m-labs/milkymist/cores/tmu2/test_all/lena.jpg

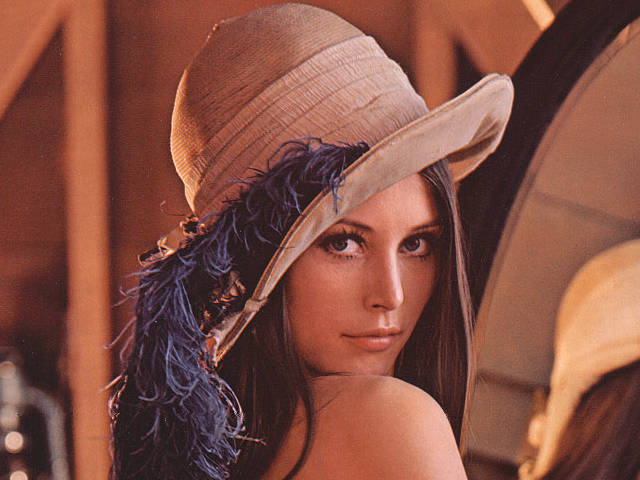
cores/tmu2/test_all/lena.jpg
