m-labs/milkymist/cores/fmlbrg/rtl/fmlbrg_datamem.v

/*
 * Milkymist SoC
 * Copyright (C) 2007, 2008, 2009, 2010 Sebastien Bourdeauducq
 *
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
 * You should have received a copy of the GNU General Public License
 * along with this program.  If not, see <http://www.gnu.org/licenses/>.
 */

module fmlbrg_datamem #(
	parameter depth = 11
) (
	input sys_clk,

	/* Primary port (read-write) */
	input [depth-1:0] a,
	input [7:0] we,
	input [63:0] di,
	output [63:0] do,

	/* Secondary port (read-only) */
	input [depth-1:0] a2,
	output [63:0] do2
);

reg [7:0] ram0[0:(1 << depth)-1];
reg [7:0] ram1[0:(1 << depth)-1];
reg [7:0] ram2[0:(1 << depth)-1];
reg [7:0] ram3[0:(1 << depth)-1];
reg [7:0] ram4[0:(1 << depth)-1];
reg [7:0] ram5[0:(1 << depth)-1];
reg [7:0] ram6[0:(1 << depth)-1];
reg [7:0] ram7[0:(1 << depth)-1];

wire [7:0] ram0di;
wire [7:0] ram1di;
wire [7:0] ram2di;
wire [7:0] ram3di;
wire [7:0] ram4di;
wire [7:0] ram5di;
wire [7:0] ram6di;
wire [7:0] ram7di;

wire [7:0] ram0do;
wire [7:0] ram1do;
wire [7:0] ram2do;
wire [7:0] ram3do;
wire [7:0] ram4do;
wire [7:0] ram5do;
wire [7:0] ram6do;
wire [7:0] ram7do;

wire [7:0] ram0do2;
wire [7:0] ram1do2;
wire [7:0] ram2do2;
wire [7:0] ram3do2;
wire [7:0] ram4do2;
wire [7:0] ram5do2;
wire [7:0] ram6do2;
wire [7:0] ram7do2;

reg [depth-1:0] a_r;
reg [depth-1:0] a2_r;

always @(posedge sys_clk) begin
	a_r <= a;
	a2_r <= a2;
end

always @(posedge sys_clk) begin
	if(we[0])
		ram0[a] <= ram0di;
end
assign ram0do = ram0[a_r];
assign ram0do2 = ram0[a2_r];

always @(posedge sys_clk) begin
	if(we[1])
		ram1[a] <= ram1di;
end
assign ram1do = ram1[a_r];
assign ram1do2 = ram1[a2_r];

always @(posedge sys_clk) begin
	if(we[2])
		ram2[a] <= ram2di;
end
assign ram2do = ram2[a_r];
assign ram2do2 = ram2[a2_r];

always @(posedge sys_clk) begin
	if(we[3])
		ram3[a] <= ram3di;
end
assign ram3do = ram3[a_r];
assign ram3do2 = ram3[a2_r];

always @(posedge sys_clk) begin
	if(we[4])
		ram4[a] <= ram4di;
end
assign ram4do = ram4[a_r];
assign ram4do2 = ram4[a2_r];

always @(posedge sys_clk) begin
	if(we[5])
		ram5[a] <= ram5di;
end
assign ram5do = ram5[a_r];
assign ram5do2 = ram5[a2_r];

always @(posedge sys_clk) begin
	if(we[6])
		ram6[a] <= ram6di;
end
assign ram6do = ram6[a_r];
assign ram6do2 = ram6[a2_r];

always @(posedge sys_clk) begin
	if(we[7])
		ram7[a] <= ram7di;
end
assign ram7do = ram7[a_r];
assign ram7do2 = ram7[a2_r];

assign ram0di = di[7:0];
assign ram1di = di[15:8];
assign ram2di = di[23:16];
assign ram3di = di[31:24];
assign ram4di = di[39:32];
assign ram5di = di[47:40];
assign ram6di = di[55:48];
assign ram7di = di[63:56];

assign do = {ram7do, ram6do, ram5do, ram4do, ram3do, ram2do, ram1do, ram0do};
assign do2 = {ram7do2, ram6do2, ram5do2, ram4do2, ram3do2, ram2do2, ram1do2, ram0do2};

endmodule
