m-labs/milkymist/cores/hpdmc_ddr32/rtl/spartan6/hpdmc_ddrio.v

/*
 * Milkymist SoC
 * Copyright (C) 2007, 2008, 2009, 2010 Sebastien Bourdeauducq
 *
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
 * You should have received a copy of the GNU General Public License
 * along with this program.  If not, see <http://www.gnu.org/licenses/>.
 */

module hpdmc_ddrio(
	input sys_clk,
	input sys_clk_n,

	input direction,
	input [7:0] mo,
	input [63:0] do,
	output [63:0] di,
	
	output [3:0] sdram_dm,
	inout [31:0] sdram_dq,
	inout [3:0] sdram_dqs,
	
	input idelay_rst,
	input idelay_ce,
	input idelay_inc,
	input idelay_cal
);

/******/
/* DQ */
/******/

wire [31:0] sdram_dq_t;
wire [31:0] sdram_dq_out;
wire [31:0] sdram_dq_in;
wire [31:0] sdram_dq_in_delayed;

hpdmc_iobuf32 iobuf_dq(
	.T(sdram_dq_t),
	.I(sdram_dq_out),
	.O(sdram_dq_in),
	.IO(sdram_dq)
);

hpdmc_oddr32 oddr_dq_t(
	.Q(sdram_dq_t),
	.C0(sys_clk),
	.C1(sys_clk_n),
	.CE(1'b1),
	.D0({32{direction}}),
	.D1({32{direction}}),
	.R(1'b0),
	.S(1'b0)
);

hpdmc_oddr32 oddr_dq(
	.Q(sdram_dq_out),
	.C0(sys_clk),
	.C1(sys_clk_n),
	.CE(1'b1),
	.D0(do[63:32]),
	.D1(do[31:0]),
	.R(1'b0),
	.S(1'b0)
);

hpdmc_idelay32 dq_delay(
	.IDATAIN(sdram_dq_in),
	.DATAOUT(sdram_dq_in_delayed),
	.INC(idelay_inc),
	.CE(idelay_ce),
	.RST(idelay_rst),
	.CAL(idelay_cal),
	.CLK(sys_clk),
	.IOCLK0(sys_clk),
	.IOCLK1(sys_clk_n)
);

hpdmc_iddr32 iddr_dq(
	.Q0(di[31:0]),
	.Q1(di[63:32]),
	.C0(sys_clk),
	.C1(sys_clk_n),
	.CE(1'b1),
	.D(sdram_dq_in_delayed),
	.R(1'b0),
	.S(1'b0)
);

/*******/
/* DM */
/*******/

hpdmc_oddr4 oddr_dm(
	.Q(sdram_dm),
	.C0(sys_clk),
	.C1(sys_clk_n),
	.CE(1'b1),
	.D0(mo[7:4]),
	.D1(mo[3:0]),
	.R(1'b0),
	.S(1'b0)
);

/*******/
/* DQS */
/*******/

wire [3:0] sdram_dqs_t;
wire [3:0] sdram_dqs_out;
wire [3:0] sdram_dqs_in_undelayed;
wire [3:0] sdram_dqs_in; /* TODO: use this for clocking input regs */

hpdmc_iobuf4 iobuf_dqs(
	.T(sdram_dqs_t),
	.I(sdram_dqs_out),
	.O(sdram_dqs_in_undelayed),
	.IO(sdram_dqs)
);

wire [3:0] sdram_dqs_t_undelayed;
wire [3:0] sdram_dqs_out_undelayed;

hpdmc_iodelay4 dqs_delay(
	.IDATAIN(sdram_dqs_in_undelayed),
	.DATAOUT(sdram_dqs_in),

	.T(sdram_dqs_t_undelayed),
	.TOUT(sdram_dqs_t),
	.ODATAIN(sdram_dqs_out_undelayed),
	.DOUT(sdram_dqs_out),
	
	.INC(1'b0),
	.CE(1'b0),
	.RST(idelay_rst),
	.CAL(idelay_cal),
	.CLK(sys_clk),
	.IOCLK0(sys_clk),
	.IOCLK1(sys_clk_n)
);

hpdmc_oddr4 oddr_dqs_t(
	.Q(sdram_dqs_t_undelayed),
	.C0(sys_clk),
	.C1(sys_clk_n),
	.CE(1'b1),
	.D0({4{direction}}),
	.D1({4{direction}}),
	.R(1'b0),
	.S(1'b0)
);

hpdmc_oddr4 oddr_dqs(
	.Q(sdram_dqs_out_undelayed),
	.C0(sys_clk),
	.C1(sys_clk_n),
	.CE(1'b1),
	.D0(4'hf),
	.D1(4'h0),
	.R(1'b0),
	.S(1'b0)
);

endmodule
