m-labs/milkymist/softusb-input/crc.c

/*
 * Milkymist SoC (USB firmware)
 * Copyright (C) 2007, 2008, 2009, 2010 Sebastien Bourdeauducq
 *
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
 * You should have received a copy of the GNU General Public License
 * along with this program.  If not, see <http://www.gnu.org/licenses/>.
 */

#include "progmem.h"
#include "crc.h"

unsigned char usb_crc5(unsigned char b1, unsigned char b2)
{
	unsigned char crc;
	unsigned char nextb;
	unsigned char so;
	unsigned char i;

	crc = 0x1f;

	for(i=0;i<8;i++) {
		nextb = b1 & 0x01;
		b1 >>= 1;
		so = crc & 0x01;
		crc >>= 1;
		if(nextb != so)
			crc ^= 0x14;
	}
	for(i=0;i<3;i++) {
		nextb = b2 & 0x01;
		b2 >>= 1;
		so = crc & 0x01;
		crc >>= 1;
		if(nextb != so)
			crc ^= 0x14;
	}

	crc &= 0x1f;
	crc ^= 0x1f;

	return crc;
}

/* CRC16 based on usbdrvasm18.inc from V-USB */
static const char crc_table_lo[] PROGMEM = {
	0x00, 0xC1, 0x81, 0x40, 0x01, 0xC0, 0x80, 0x41,
	0x01, 0xC0, 0x80, 0x41, 0x00, 0xC1, 0x81, 0x40,
	0x01, 0xC0, 0x80, 0x41, 0x00, 0xC1, 0x81, 0x40,
	0x00, 0xC1, 0x81, 0x40, 0x01, 0xC0, 0x80, 0x41,
	0x01, 0xC0, 0x80, 0x41, 0x00, 0xC1, 0x81, 0x40,
	0x00, 0xC1, 0x81, 0x40, 0x01, 0xC0, 0x80, 0x41,
	0x00, 0xC1, 0x81, 0x40, 0x01, 0xC0, 0x80, 0x41,
	0x01, 0xC0, 0x80, 0x41, 0x00, 0xC1, 0x81, 0x40,
	0x01, 0xC0, 0x80, 0x41, 0x00, 0xC1, 0x81, 0x40,
	0x00, 0xC1, 0x81, 0x40, 0x01, 0xC0, 0x80, 0x41,
	0x00, 0xC1, 0x81, 0x40, 0x01, 0xC0, 0x80, 0x41,
	0x01, 0xC0, 0x80, 0x41, 0x00, 0xC1, 0x81, 0x40,
	0x00, 0xC1, 0x81, 0x40, 0x01, 0xC0, 0x80, 0x41,
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
{
	unsigned char lo, hi;
	unsigned char i;
	unsigned char idx;
	
	lo = 0xff;
	hi = 0xff;
	for(i=0;i<len;i++) {
		idx = lo ^ msg[i];
		lo = read_pgm_byte(crc_table_lo + idx) ^ hi;
		hi = read_pgm_byte(crc_table_hi + idx);
	}
	dest[0] = ~lo;
	dest[1] = ~hi;
}
