m-labs/milkymist/cores/softusb/navre_regress/tb_regress.v

/*
 * Milkymist SoC
 * Copyright (C) 2007, 2008, 2009, 2010 Sebastien Bourdeauducq
 *
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
 * You should have received a copy of the GNU General Public License
 * along with this program.  If not, see <http://www.gnu.org/licenses/>.
 */

module tb_regress();

reg sys_clk;
initial sys_clk = 1'b1;
always #5 sys_clk = ~sys_clk;

reg sys_rst;

wire pmem_ce;
wire [11:0] pmem_a;
reg [15:0] pmem_d;

reg [15:0] pmem[0:4095];

always @(posedge sys_clk) begin
	if(pmem_ce)
		pmem_d <= pmem[pmem_a];
end


wire dmem_we;
wire [9:0] dmem_a;
reg [7:0] dmem_di;
wire [7:0] dmem_do;

reg [7:0] dmem[0:1023];

always @(posedge sys_clk) begin
	if(dmem_we) begin
		//$display("DMEM WRITE: adr=%d dat=%d", dmem_a, dmem_do);
		dmem[dmem_a] <= dmem_do;
	end
	dmem_di <= dmem[dmem_a];
end

wire io_re;
wire io_we;
wire [5:0] io_a;
wire [7:0] io_do;
reg [7:0] io_di;

always @(posedge sys_clk) begin
	if(~sys_rst) begin
		if(io_re) begin
			$display("IO READ adr=%x", io_a);
			io_di <= io_a;
		end
		if(io_we) begin
			$display("IO WRITE adr=%x dat=%x", io_a, io_do);
		end
	end
end

task dump;
integer i;
begin
	$display("DUMP DMEM");
	for(i=0;i<1023;i=i+1)
		$display("%x", dmem[i]);
end
endtask

softusb_navre #(
	.pmem_width(12),
	.dmem_width(10)
) dut (
	.clk(sys_clk),
	.rst(sys_rst),

	.pmem_ce(pmem_ce),
	.pmem_a(pmem_a),
	.pmem_d(pmem_d),

	.dmem_we(dmem_we),
	.dmem_a(dmem_a),
	.dmem_di(dmem_di),
	.dmem_do(dmem_do),

	.io_re(io_re),
	.io_we(io_we),
	.io_a(io_a),
	.io_do(io_do),
	.io_di(io_di),

	.irq(8'b0),

	.dbg_pc()
);

initial begin
	$readmemh("flash.rom", pmem);
	$readmemh("sram.rom", dmem);
	sys_rst = 1'b1;
	#15;
	sys_rst = 1'b0;
end

endmodule
