m-labs/milkymist/cores/tmu2/rtl/tmu2_tdpram.v

/*
 * Milkymist SoC
 * Copyright (C) 2007, 2008, 2009, 2010, 2011 Sebastien Bourdeauducq
 *
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
 * You should have received a copy of the GNU General Public License
 * along with this program.  If not, see <http://www.gnu.org/licenses/>.
 */

/* Dual-port RAM with dual write-capable port */

module tmu2_tdpram #(
	parameter depth = 11, /* < log2 of the capacity in words */
	parameter width = 32
) (
	input sys_clk,

	input [depth-1:0] a,
	input we,
	input [width-1:0] di,
	output reg [width-1:0] do,

	input [depth-1:0] a2,
	input we2,
	input [width-1:0] di2,
	output reg [width-1:0] do2
);

reg [width-1:0] ram[0:(1 << depth)-1];


always @(posedge sys_clk) begin
	if(we)
		ram[a] <= di;
	do <= ram[a];
end

always @(posedge sys_clk) begin
	if(we2)
		ram[a2] <= di2;
	do2 <= ram[a2];
end

// synthesis translate_off

/*
 * For some reason, in Verilog the result of an undefined multiplied by zero
 * seems to be undefined.
 * This causes problems with pixels that texcache won't fetch because some fractional
 * parts are zero: the blend unit yields an undefined result on those, instead of ignoring
 * the contribution of the undefined pixel.
 * Work around this by initializing the memories.
 */

integer i;
initial begin
	for(i=0;i<(1 << depth);i=i+1)
		ram[i] = 0;
end

// synthesis translate_on

endmodule
