m-labs/milkymist/cores/vgafb/rtl/vgafb_fifo64to16.v

/*
 * Milkymist SoC
 * Copyright (C) 2007, 2008, 2009 Sebastien Bourdeauducq
 *
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
 * You should have received a copy of the GNU General Public License
 * along with this program.  If not, see <http://www.gnu.org/licenses/>.
 */

module vgafb_fifo64to16(
	input sys_clk,
	input vga_rst,
	
	input stb,
	input [63:0] di,
	
	output can_burst,
	output do_valid,
	output reg [15:0] do,
	input next /* should only be asserted when do_valid = 1 */
);

/*
 * FIFO can hold 8 64-bit words
 * that is 32 16-bit words.
 */

reg [63:0] storage[0:7];
reg [2:0] produce; /* in 64-bit words */
reg [4:0] consume; /* in 16-bit words */
/*
 * 16-bit words stored in the FIFO, 0-32 (33 possible values)
 */
reg [5:0] level;

wire [63:0] do64;
assign do64 = storage[consume[4:2]];

always @(*) begin
	case(consume[1:0])
		2'd0: do <= do64[63:48];
		2'd1: do <= do64[47:32];
		2'd2: do <= do64[31:16];
		2'd3: do <= do64[15:0];
	endcase
end

always @(posedge sys_clk) begin
	if(vga_rst) begin
		produce = 3'd0;
		consume = 5'd0;
		level = 6'd0;
	end else begin
		if(stb) begin
			storage[produce] = di;
			produce = produce + 3'd1;
			level = level + 6'd4;
		end
		if(next) begin /* next should only be asserted when do_valid = 1 */
			consume = consume + 5'd1;
			level = level - 6'd1;
		end
	end
end

assign do_valid = ~(level == 6'd0);
assign can_burst = level <= 6'd16;

endmodule
