m-labs/milkymist/(commit log)

2009-08-17 Import into GitHub
    [texel_cache.ods]
2009-08-19 Move LM32 config to board dir
2009-08-21 Sync UART operation for crash debugging
2009-08-23 Working on Avnet board
2009-09-06 Milkymist One board WIP
2009-09-08 Fixed DDR I/O problems
    [hpdmc.v, hpdmc_datactl.v, hpdmc_ddrio.v, setup.v]
2009-09-12 Fixed buffer overflow in cffat
    [cffat.c]
2009-09-20 WIP fix synthesis for S6 with ISE 11.3
    [hpdmc_oddr4.v]
2009-09-23 kernel reboot (support warm boot entry @ 0x00000100)
    [main.c]
2009-10-02 Moved files
    [texel_cache.ods]
2009-10-02 Missing files
    [texel_cache.ods]
2009-11-05 merged (original)
    [flasher-routed_pad.csv, texel_cache.ods]
2009-11-08 Configurable byte swap in norflash8
    [norflash8.v, system.v, vga.h]
2009-11-12 Active high interrupts in LM32
2009-11-13 Edge sensitive IRQ on UART
2009-11-13 UART fix
2009-11-13 Timer fix
2009-12-12 Workaround for strange Xst bug
    [fmlbrg_datamem.v, hpdmc_ddrio.v, setup.v]
2009-12-29 PS/2 interrupt doc
2010-01-10 Reverted to old VGA, new one does not work
    [setup.v, vga.v, vgafb.v]
2010-01-14 Dropped support for Avnet Spartan3A board - now available as Fallen's fork
2010-01-30 SDRAM timing fixes from Zeus
    [hpdmc_datactl.v, setup.v]
2010-02-02 vdivops stage + tb
2010-02-02 connected, syntax ok, not working
    [tmu2.v, tmu2_divider17.v, tmu2_geninterp18.v, tmu2_vdivops.v, tmu2_vinterp.v]
2010-02-08 Vertical interpolation bugfix WIP
    [tb_tmu2.v, tmu2.v, tmu2_geninterp18.v, tmu2_vdiv.v, tmu2_vdivops.v, tmu2_vinterp.v]
2010-02-09 Avoid Verilog trap (thanks Paul Campbell for pointing that out)
    [tmu2_geninterp18.v, tmu2_hinterp.v]
2010-02-09 mask + clamp
2010-02-13 Bilinear filtering OK in simulation
2010-02-14 Model using DSP48 primitives to work around Xst bugs
    [DSP48.v, tb_tmu2.v]
2010-02-14 workarounds for synthesizer problems
    [tb_tmu2.v, tmu2_blend.v, tmu2_mult2.v, tmu2_qpram.v]
2010-02-14 Fixed CE pin on multipliers + iverilog support
    [tb_tmu2.v, tmu2.v, tmu2_blend.v, tmu2_mult2.v, vpi_images.c]
2010-02-15 new write buffer doesnt work, simulators and synthesizers all give different results, fuck it and revert to the old one
    [DSP48.v, tb_tmu2.v, tmu2.v, vpi_images.c]
2010-02-15 Fixed clamp unit
2010-02-15 Improved PFPU timing + SW fixes
    [pfpu_dma.v, tb_pfpu.v]
2010-02-15 Simpler and smaller PFPU DMA engine
2010-02-16 Fixes + hack for picture brightness
    [pfpu.v]
2010-02-17 fix borders + initialize audio peaks + silently skip audio buffers
    [snd.c]
2010-02-18 TMU2 documentation
    [texel_cache.ods]
2010-02-26 interrupt numbers
2010-02-28 Use board description
2010-03-21 Fix typo in sysctl.tex (address of capabilities register) + move libbase include files
    [crc.h]
2010-03-28 Use FPVM in demo firmware (unfinished, broken)
    [libc.c]
2010-04-07 New FML arbiter, fixed DRAM write-to-read timing, alpha blending OK on hardware
    [fmlarb.v, hpdmc_datactl.v, system.v, tb_tmu2.v, tb_tmu2_arb.v, tmu2.v]
2010-04-14 Fixed race conditions in UI
    [main.c]
2010-04-25 Bilinear filtering explanation
2010-05-03 Section about wrapping/clamping
2010-05-07 Fix figure for BW prints
2010-05-16 libHPDMC with manual calibration
2010-06-21 BIOS starting on M1, SDRAM not working
    [norflash16.v]
2010-06-22 Ethernet working (experimental, random FIFO problems)
    [setup.v, system.v]
2010-06-22 PFPU working on M1. Added 1 pipeline stage to meet timing on multiplier.
2010-06-24 3 buttons pressed = hardware reset
    [system.v]
2010-06-28 Video input FIFO + DMA engine, untested
2010-06-28 Bugfixes in VPI image module
    [vpi_images.c]
2010-06-29 Integrated video in. Working but cleanup-needing I2C functions.
2010-06-30 I2C cleanup
2010-07-07 conbus: ignore the MSB
    This shadows 0000_0000-7fff_ffff to 8000_0000-ffff_ffff, which gives the
    possibility to access every device in cached and non-cached mode.
    The change also creates a new memory map:
    - NOR 0x00000000 (shadow @0x80000000)
    - USB 0x20000000 (shadow @0xa0000000)
    - FML bridge 0x40000000 (shadow @0xc0000000)
    - CSR bridge 0x60000000 (shadow @0xe0000000)
2010-07-08 Swap flash bytes for impact
    [norflash16.v]
2010-07-12 ZPU testbench + working on board
2010-07-13 Disable ZPU interrupts
2010-07-13 Fixed video in compilation warnings
    [vin.c]
2010-07-13 Fixed video in compilation warnings (again)
    [vin.c]
2010-07-14 Detect USB devices connection
2010-07-16 Fixed SIE address decoder
    [softusb_sie.v]
2010-07-19 Improved test bench + bugfixes
    [softusb_navre.v, tb_navre.v]
2010-07-19 Push/pop instructions + bugfixes. Recursive fibonacci works.
    [softusb_navre.v, tb_navre.v]
2010-07-20 Bugfixes - basic USB TX to SIE working
    [main.c, softusb.v, softusb_dpram.v, softusb_navre.v, softusb_ram.v, softusb_sie.v, tb_softusb.v]
2010-07-21 Load AVR firmware from HAL + fixes
    [softusb_ram.v, tb_softusb.v, usb.c]
2010-07-23 Multi RX slot in BIOS netboot + keep IRQ line asserted with RX reset
2010-07-23 Work around BRAM silicon bug^URespect conflict avoidance requirements
    [softusb_dpram.v]
2010-07-25 Memory card controller fixes + test bench
    [memcard.v, tb_memcard.v]
2010-07-28 Fixed timing problems + OHCI firmware cleanup
    [debug.c, main.c, pfpu.h, pfpu_faddsub.v]
2010-07-29 Display device connection and disconnection
2010-08-01 fix stupid metastability problem
    [main.c, sie.h, softusb_phy.v, softusb_rx.v]
2010-08-01 Do not tickle EDA tool bugs
    [softusb_tx.v]
2010-08-02 Map SREG at 0x3f + do not generate interrupt related instruction
2010-08-02 Cleanup IOs, USB device descriptor generally read correctly. Some bytes corrupted because of Navre bugs
    [debug.c, debug.h, io.h, main.c, progmem.h, sie.h, tb_navre.v, timer.h]
2010-08-02 Enable everything and fix timing problems
    [setup.v]
2010-08-03 Fix access to the upper 64M of SDRAM
    [fmlbrg.v, setup.v, tb_fmlbrg.v]
2010-08-12 Prevent DMX TX glitches
    [dmx_tx.v]
2010-08-12 DMX input working on the board
2010-08-19 Fixed Z handling with carry
    [softusb_navre.v]
2010-08-19 Fixed LDS instruction. All tests passing
    [softusb_navre.v]
2010-08-24 UART Thru mode
2010-08-30 Fix rescue bitstream load addresses
    [standby.v]
2010-08-31 Fix some SDRAM timing problems, new commands to control data input delay
    [ddram.v, hpdmc.v, hpdmc_ddrio.v, iodelay2.v]
2010-09-02 Demo firmware fix + video mode definitions
    [asfifo.v, system.v, vga.c, vga.h, vga.v]
2010-09-05 More sophisticated SDRAM clocking + disallow continuous read bursts (tickles some bug, why?)
    [boot.h, ddram.v, hpdmc.v, hpdmc_datactl.v, hpdmc_ddrio.v, main.c]
2010-09-06 Use the correct AC97 clock
    [system.v]
2010-09-10 Revert to data IDELAY for SDRAM DQ + use direct BUFG for AC97 clock
    [hpdmc_ddrio.v, system.v]
2010-09-10 Update calibration value in BIOS
2010-09-17 Fix program memory read in AVR firmware
    [progmem.h]
2010-09-18 Wishbone burst write support (nb: timing might be broken)
    [fmlbrg.v, tb_fmlbrg.v]
2010-09-21 Some monitor ROM fixes
    [monitor.v, system.v, tb_monitor.v]
2010-09-23 Print USB VID/PID (when lucky)
2010-09-25 Fix USB tx_busy generation
    [debug.c, io.h, softusb_filter.v, softusb_phy.v, softusb_sie.v]
2010-09-25 USB debug prints
2010-09-25 PCB revision readout
2010-09-30 USB bugfixes. Still many intermittent problems but now works with more than one device.
    [debug.c, main.c, softusb_rx.v]
2010-09-30 Report USB bit stuffing errors
    [main.c, sie.h, softusb_phy.v, softusb_rx.v, softusb_sie.v]
2010-09-30 Fix USB TX->RX switching generated glitches
    [softusb_phy.v]
2010-09-30 Retry on USB error
    [main.c]
2010-09-30 Use counter to reset RX + simpler xfer functions
    [main.c, softusb_filter.v, softusb_phy.v]
2010-09-30 Check interface descriptor and determine device type
2010-09-30 Print keyboard codes
2010-10-01 Keyboard codes transmission + interrupts (untested)
2010-10-01 Console hooks + use HAL and interrupts in BIOS
2010-10-01 Toggle console with ESC
2010-10-04 Atomic console prints
2010-10-05 More conservative interrupt handling
2010-10-05 Version command + fixes
    [main.c]
2010-10-05 Nested UART RX interrupt
2010-10-07 remove missing signal from tb
    [tb_sie.v]
2010-10-08 Fix USB disconnect bug on port A
    [main.c]
2010-10-08 Fix USB data packet handling
    [main.c]
2010-10-08 Do not send keepalive to unsupported devices (like full speed)
2010-10-08 USB cleanup + fix DATAx mismatch handling
    [main.c]
2010-10-15 Fix PFPU program load
    [pfpu.c]
2010-10-19 Fixes for HW debugging (Michael Walle)
    [norflash16.v, system.v, tb_norflash16.v]
2010-10-28 USB: fixed 'missing sync word' bug
    [softusb_tx.v]
2010-10-28 Last major USB bug gone
    [softusb_phy.v, softusb_rx.v]
2010-11-10 Work around GNUtard problems (http://gcc.gnu.org/bugzilla/show_bug.cgi?id=46261)
    [debug.c, debug.h, libc.c, libc.h, main.c, progmem.h]
2010-11-16 Fix boot problem with RTEMS 4.5 GCC toolchain
    [boot.c]
2010-11-18 Fix rescue mode detection
    [main.c]
2011-03-03 Use timer for boot timeout
2011-03-04 Claim to support PCB revision 2 (RC3 run)
2011-03-27 AC97: zero out invalid frames (needed for WM9707) and fix loading of downstream data register in full duplex operation
    [ac97_ctlif.v, ac97_dma.v]
2011-03-28 Support video mode switching
2011-03-31 uart: begin sampling with falling edge
2011-03-31 uart: fix thru bit initialization
2011-03-31 uart: add break support
    This patch adds UART BREAK support. A BREAK signal violates the framing by
    transmitting a logical 0 for a period that is at least longer than one
    frame.
2011-04-04 uart: add a tx pending status bit
2011-04-04 add UART BREAK support to the SoC
2011-04-04 gdbstub: initial import
    This patch adds a gdb stub which replaces the tiny LM32 debug monitor. It
    needs some more resources but has the advantage that you can directly
    connect with GDB.
    [gdbstub.c]
2011-04-05 flterm: add gdbpassthrough support
    This patch adds support for GDB packets and serial console demuxing. To use
    it start flterm with --gdb-passthrough. Then start gdb and run the
    following commands:
    set remote interrupt-on-connect on
    target remote <pseudo terminal printed by flterm>
    Note: there is _no_ 'set remote interrupt-sequence BREAK'. flterm takes
    care of converting Ctrl+C (ETX) to a BREAK.
2011-04-07 Ethernet: workaround for permanent RX FIFO overflow bug
    [system.v]
2011-04-07 gdbstub: fix max packet size reporting
    [gdbstub.c]
2011-04-08 Ethernet: simplifications and fixes
    [tb_minimac.v]
2011-04-10 minimac2: ground unused BRAM port to make bitgen happy
2011-04-10 Fix slave address decoding
    [conbus5x6.v]
2011-04-10 minimac2: fix block RAM WE
    [minimac2_memory.v]
2011-04-23 Do not assert PHY reset for too long
    [minimac2_ctlif.v]
2011-04-28 BIOS: disable splash screen and console to prevent unnecessary screen flickering
    The BIOS now disables the video output completely unless one of the following conditions is met:
    * Boot in rescue mode
    * Boot failure
    * Boot aborted by user
    * Power button pressed for more than 1 second (approx.)
    [boot.c, main.c, vga.c, vga.h]
2011-05-01 Standby: debounce keys, only power up on rising edge
2011-06-10 rc5.v: fixed the timing problem thanks Jack
    Acked-by: Jack <jackchen_2004@hotmail.com> <QQ:51666535>
    [rc5.v]
2011-06-15 BIOS: reset ethernet PHY a second time
    [main.c]
2011-06-21 bt656cap: send IRQ at end of frame, not at start...
2011-07-20 lm32: sync to upstream v3.6 sources
    - feature: support for dynamically switching EBA to DEBA via a GPIO.
    - bug: EA now reports instruction that caused the data abort, rather than
    next instruction.
2011-07-24 TMU prefetch: fixed compilation errors
    [tmu2_datamem.v, tmu2_fetchtexel.v, tmu2_fifo64to256.v, tmu2_qpram.v, tmu2_serialize.v, tmu2_tagmem.v, tmu2_texmem.v]
2011-07-24 TMU prefetch: fix Xst warnings
    [tmu2_datamem.v, tmu2_fifo64to256.v, tmu2_tagmem.v, tmu2_texmem.v]
2011-07-25 TMU prefetch: fix qpram module
    [tmu2_qpram.v]
2011-07-25 TMU prefetch: fix split module
    [tmu2_split.v]
2011-07-25 tmubench: send data to UART only
2011-07-26 TMU prefetch: fix commit FIFO write indexing
    [tmu2_fifo64to256.v]
2011-07-26 TMU prefetch: fix qpram read-after-write
    [tmu2_datamem.v]
2011-07-26 TMU prefetch: fix pipe ack generation in tagmem
    [tmu2_tagmem.v]
2011-09-13 uart: add status and control register
2011-09-13 update header files for new uart core
2011-09-13 libhpdmc: support new uart core
2011-09-13 gdbstub: support new uart core
2011-09-13 bios/demo: support new uart core
2011-09-13 reassign interrupts
    Remove 'holes' from the interrupt map.
2011-10-03 lnfpus.c: made thread-safe by removing global variable "sc"
2011-11-10 gdbstub: fix off-by-one error (Michael Walle)
    [gdbstub.c]
2011-11-12 Drive PHY reset when Ethernet is disabled
    [system.v]
2011-11-12 Generate bus errors on the first 512KB to catch NULL pointers
    [system.v]
2011-11-13 softusb-input: also accept 3 byte reports, e.g., from wheelless mice
2011-11-13 softusb: don't interrupt the host if we're ignoring the packet anyway
2011-11-13 softusb: renamed "fs" to "full_speed"
    No need to be *that* tight-lipped ...
    [main.c]
2011-11-13 softusb: support composite USB devices
    For this, we parse the entire configuration descriptor and look at
    all interface descriptors. Furthermore, we set the endpoint number
    according to the endpoint descriptor(s) following the interface
    descriptor, instead of hard-coding it.
    Here is a brief description of how composite devices are structured:
    http://atmel.com/dyn/resources/prod_documents/doc7805.pdf
    Note that this doesn't help with combi-devices that present
    themselves as independent devices plus a hub.
    We still bail out at the first interface descriptor we don't
    understand, to avoid wandering into crazy things that may be lurking
    at tne end of the configuration descriptor. (I did this on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
    [main.c]
2011-11-14 USB: try enumerating full speed devices
2011-11-14 USB: shorter timeouts, fewer retries
    [main.c]
2011-11-15 softusb: implement the reset recovery interval
    Sections 7.1.7.5 and 9.2.6.2 of the USB 2.0 spec say the a host has
    to wait for at least 10 ms (Trstrcy) after reset before it can expect
    a device to be able to receive data.
    In Linux drivers/usb/core/hub.c:hub_port_reset we find this:
    /* TRSTRCY = 10 ms; plus some extra */
    msleep(10 + 40);
    So let's use 50 ms.
    [main.c]
2011-11-15 USB: send SOFs and keepalives on both ports and immediately after reset
    [main.c]
2011-11-19 softusb: simplify and correct data toggle in control transactions
    This patch does three things:
    1) it replaces get_data_token with a simpler and more efficient
    version that doesn't unconditionally toggle
    2) it only toggles the transmitter-side sequence if the DATAx
    packet is acknowledged (USB 1.1 sec 8.6 pg 168 and USB 2.0
    sec 8.6 pg 232)
    3) it always sends DATA1 in the status stage, in accordance with
    USB 1.1 sec 8.5.2 pg 165 and USB 2.0 sec 8.5.3 pg 226.
    In testing, this patch reduced the probability of the low-speed device
    used (the Rii RF keyboard) registering. This seems to simply be the
    effect of bugs eliminated in later patches having a greater effect,
    and does not con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
    [main.c]
2011-11-19 softusb: use toggle() also for bulk/interrupt
2011-11-19 softusb: swap in_reply and out_reply
    [main.c]
2011-11-19 softusb: move all IN transfers to function usb_in
    Besides reducing some redundancy, this patch also makes the following
    changes:
    - retry on timeout (e.g., if the DATAx packet was garbled) in the data
    stage of control transfers instead of failing the entire transfer
    - retry IN tranfers in the status stage
    - reject IN transfers in the status stage if they have the wrong
    sequence bit (more USB 1.1 sec 8.5.2 and USB 2.0 sec 8.5.3)
    - slightly reduce the information in debugging output since control
    and bulk/interrupt now use the same code path for IN transfers
    The streamlined code path also makes full-speed work occasionally.
    [main.c]
2011-11-19 softusb: partially unroll usb_in
    This patch partially unrolls usb_in and takes decisions on the further
    disposition of a packet at early as possible. The objective is to
    minimize the processing needed between EOP of the DATAx packet and the
    sending of an ACK.
    The patch also changes error handling in two ways:
    1) when deciding to discard a packet, always wait until the device
    really stops sending
    2) packets with a garbled PID are treated as non-fatal errors
    [main.c]
2011-11-19 softusb: send ACKs from dedicated inline function
    To accelerate sending ACKs, this patch avoids the call setup overhead
    of usb_tx and introduces a dedicated inline function. In experiments,
    this reduced EOP-to-ACK time by about 10 full-speed bit times.
    [main.c]
2011-11-19 softusb: fail garbled packets fatally again
    As the result of more testing that showed no degradation in performance,
    this reverts to the original logic of failing garbled packets harder.
    [main.c]
2011-11-19 softusb: convert last remaining use of usb_rx to usb_rx_ack
    Since usb_rx is now only used to receive ACK/NAK, we can replace it
    with a more streamlined version. This should also marginally improve
    error handling.
    [main.c]
2011-11-19 softusb: clear EPs on disconnect
    Along with the logic to handle multiple interfaces, commit
    a26dc5116da806b5180958b0d5007d318c2a887b also introduced the following
    bug:
    When a keyboard or composite device with keyboard was replaced by a
    mouse after enumeration, the stack would still poll the "keyboard",
    which most likely resulted in the mouse data to be b drained and
    discarded.
    This patch clears the EP roles on disconnect.
    [main.c]
2011-11-21 flterm: bump version number and fix print_usage output
2011-11-21 bios: fix initrd end pointer
    initrd_end points just past the last byte of the initrd. This way initramfs
    images works.
    [boot.c]
2011-11-22 sysctl: new debug control register
    Introduce a debug control register. It can be used to lock the gdbstub ROM
    and enable/disable bus errors. The gdbstub ROM will be read/writeable until
    one writes the corresponding lock bit to this register. This will ease
    future gdbstub updates.
    [sysctl.v]
2011-11-22 gdbstub: set correct uart speed
    Set the UART speed to a fixed value when gdbstub is called and restore its
    previous value if gdbstub exits.
    [gdbstub.c]
2011-11-22 gdbstub: disable bus errors
    Disable bus errors while the gdbstub is running. This will prevent nested
    gdbstub invokations.
    [gdbstub.c]
2011-11-22 soc: add enable signal to bus errors
    [system.v]
2011-11-22 bios: enable bus errors
    By default bus errors are disabled, enable them.
    [main.c]
2011-11-22 sysctl: fix ICAP address decoding
    [sysctl.v]
2011-11-23 Fix assignment to bus_errors_en
    [sysctl.v]
2011-11-28 standby: work around intermittent reconfiguration problem
    [standby.v]
2011-11-30 softusb: correct misunderstanding of use of rx_pending
    Note that this change increases the risk of rx_pending vs. rx_active
    races.
    [main.c]
2011-11-30 softusb: move (still hard-coded) device address to #define
2011-11-30 softusb: move retrieval of device descriptor to separate function
2011-11-30 softusb: end data stage of SETUP also when size limit is reached
    USB 1.1, 5.5.3, page 37: "The Data stage [...] is complete when the endpoint
    [...] Has transferred exactly the amount of data specified [.]"
2011-11-30 softusb: set EP0 size before trying any larger accesses
    For transfers of more than 8 bytes, we need to know the EP0 size
    to correctly detect the end of the transfer. This patch adds a
    new state to read the first 8 bytes of the device descriptor and
    to set the EP0 size for the following steps in enumeration.
    [main.c]
2011-11-30 softusb: minimize time between SETUP/OUT and DATAx
    By not waiting until the transmitter is idle, we can reduce the
    time between the end of the SE0 indicating EOP of SETUP or OUT
    and the first transition of the following DATAx to a mere two
    bit times (as oppose to ~6 bit times before).
    While I haven't been able to find anything in the USB standard
    that would require such tight timing, AVR USB chips (i.e., the
    ATmega32U2 of atusb and the AT90USB162 of the Faderfox LV3)
    flat out ignore any transfers with longer delays.
    [main.c]
2011-11-30 softusb: clean up device reporting
    Moved reporting of the device(s) detected out of port_service, making
    it a bit less cluttered and providing a more comfortable basis for
    future additions.
2011-11-30 softusb: added detection of MIDI devices (WIP)
2011-11-30 softusb: move protocol-specfic data processing to separate functions
    This will prevent "poll" from getting too cluttered when MIDI is added.
    [main.c]
2011-12-01 softusb: ignore the CIN when classifying USB-MIDI messages
    iCON don't always send a correct CIN value. Luckily, we can use the
    first byte of the actual MIDI message instead.
    [main.c]
2011-12-01 softusb: don't forget notifying the host when there are news from MIDI
    The host interrupt wasn't asserted when enqueuing MIDI messages.
    No surprise some controls acted strangely ...
2011-12-14 milkymist: use -Wstrict-prototypes
    And fix resulting warnings.
    [brd.c, brd.h, mem.h, pfpu.h, snd.h]
2011-12-14 milkymist: try -Wmissing-prototypes
    The math functions have too many issues to make this viable without
    substantially more fixing. Just fix what little else is there.
    [ukb.c]
2012-01-07 libfpvm: only access node->label if we have an indentifier
    We provide a function node_is_op for the library user to make this
    distiction as well (used in parser_helper.c).
    Note that this change means that we can't report the name of the
    operator that causes an "Operation not supported" error. This is
    visible to users in the case of op_not. Fix later.
2012-01-15 tools/asm: PFPU assembler
2012-01-15 pfpuasm: auto-NOP, pass all regs, and some syntax corrections
    A number of small improvements:
    - VECTOUT doesn't need a destination register (use 0)
    - QUAKE is unary, not binary
    - option -a to automatically fill the latency slots with NOP
    (without caring about efficiency)
    - all registers referenced (read or write) are listed
2012-02-10 improvement for libbase uart.c
    uart_isr, when applicable, will reset CSR_UART_STAT after it has
    written new data to the UART module. If the UART module is able
    to finish that request before uart_isr writes to CSR_UART_STAT,
    then uart_isr will end up clearing the wrong event. This prevents
    uart_isr from ever being called again, and stalls all outgoing data
    [uart.c]
2012-02-21 VGA: fix the vsync pulses
    [vga.c, vgafb_ctlif.v]
2012-03-02 softusb: added access to Navre's PC via CSR
    This is for debugging. Removed reading back the reset status via CSR,
    since it seems not very useful and we don't have to decode the address
    this way.
    [softusb.v, softusb_hostif.v, softusb_navre.v]
2012-03-02 softusb: added the usual set of -W... flags and corrected code accordingly
    The problem were:
    - missing "void" in function declarations in main.c
    - debug.c didn't include debug.h
    None of these caused actual malfunction.
    [debug.c, main.c]
2012-03-03 softusb/navre.ld: change LENGTH of data section from 32 kB to 8 kB
    This doesn't affect the code to currently generate. Just removes a
    bit of potentially misleading information.
2012-03-03 softusb: disable RX timeout message in usb_in
    We got a HUGE number of these with full-speed devices, badly spamming
    the diagnostic output.
    Note that this change may reduce the probability of successful
    enumeration: with the timeout message, 36/50 = 72% unplug-reset-plug
    cycles succeeded with LV3, while without the message, only 40/75 =
    53% did.
    [main.c]
2012-03-03 softusb: don't send SOF while in full-speed bus reset
    We started sending SOF a little too early, making it impossible to
    reset the bus without physical unplugging.
    Note that resetting an LV3 via unplug-usb_load-plug leads to
    successful enumeration with probability 40/75 = 53% while only
    usb_load yields 23/50 = 46%.
    This also introduces a failure mode not seen before where the
    LV3 enumerates ("Found MIDI") but still doesn't communicate.
    Subsequent bus resets are unsuccessful. Plug cycling helps.
    [main.c]
2012-03-04 softusb: fix two typos, one of them breaking some error detection
    If the OUT token to end a data phase wasn't ack'ed, we didn't notice.
    This still leaves the LV3 success rate at 13/25 = 52%.
    [main.c]
2012-03-04 softusb: limit IN/OUT retries in control_transfer
    If hitting persistent timeouts or an unresponsive device, we could
    loop forever. This would hang the entire USB subsystem, also for any
    devices on the other port. Also unplugging wouldn't help. Only a
    reboot or - lately - reloading the USB firmware would get out of this.
    Parameter stability:
    Retry limit for main data phase
    | Retry limit for the IN/OUT ending it
    | | LV3 successes
    | | |
    50 10 13/25 = 52%
    100 10 23/50 = 46%
    250 10 12/25 = 48%
    250 100 29/50 = 58%
    [main.c]
2012-03-04 softusb: when exhausting retries, reset the device up to three times
    This brings the LV3 success rate to 50/50 = 100%.
    [main.c]
2012-03-10 softusb-input debug: fix hexdump format
    [debug.c]
2012-04-08 softusb: remap timer to 0x20..0x23
    That way we have more registers addresses left for the SIE module.
2012-04-16 Use PLLs instead of DCMs
    Use two chained PLLs to generate all needed clocks. Besides lower clock
    jitter, this makes it possible to switch the USB clock to 72 MHz.
    [system.v]
2012-04-16 Switch USB clock to 72MHz
    Increase the USB core frequency by 50%. While the TX side needs just simple
    clock enable tweaks, the RX side needs additional states in the DPLL and
    EOP state machine.
    The two DPLL main transitions paths (1,3,2,0) and (5,7,6,4) are both
    extended by two states - (9,a) and (d,e). The state encoding has been
    chosen to match the dpll_ce logic (eg. bit 1 is 0 for clock low and bit 1
    is 1 for clock high).
    The EOP SM just need two additional SE0 sample states.
    For further information please refer to the USB whitepaper
    Designing a robust USB serial interface engine
2012-04-16 softusb-input: adjust SOF timer
    Since the core now runs with 72MHz, we have to adjust the timer value.
2012-04-16 navre: add dbg_pc port to test benches
    This will prevent some verilog warnings.
    [tb_navre.v, tb_regress.v]
2012-04-16 softusb: fix io_do width
    The IO data path is only 8 bit wide.
    [softusb_timer.v]
2012-05-10 navre: fix missing NBA conversion
    One blocking assignment was still there. Convert it.
    [softusb_navre.v]
2012-05-21 bios/boot: fix off by one error in SFL magic string
    [boot.c]
2012-05-27 software/libbase: fix memcpy handling of buffers with differing alignments
    [libc.c]
2012-11-14 lm32: replace $clog2 with macro
    Unfortunately, XST does not support $clog2 with the localparam keyword
    (the parameter keyword works just fine). Define a macro which replaces the
    call with a constant function.
    This commit can be reverted if the bug in XST is fixed.
    [lm32_config.v]
2013-01-08 softusb/navre: fix instruction decoder
    Based on patch by Florent Kermarrec
    [softusb_navre.v]
2013-01-31 Makefile: fix 'make clean' rules to use BOARD instead of hardcoded milkymist-one
